jaypeeds/SCSIknifePocket/3D models/Plaque.step

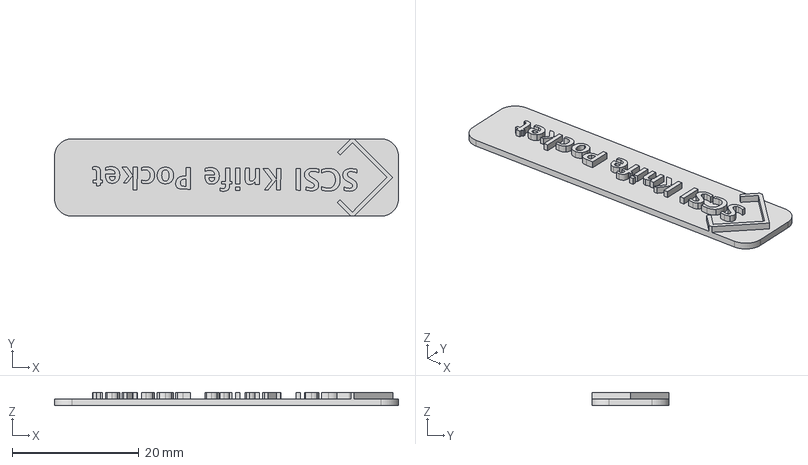
[picture p8: CAD file, 2026-02-21]
3D models/Plaque.step
54.2 x 12.2 x 2.00 mm
