jaypeeds/SCSIknifePocket/3D models/Sleeve.step

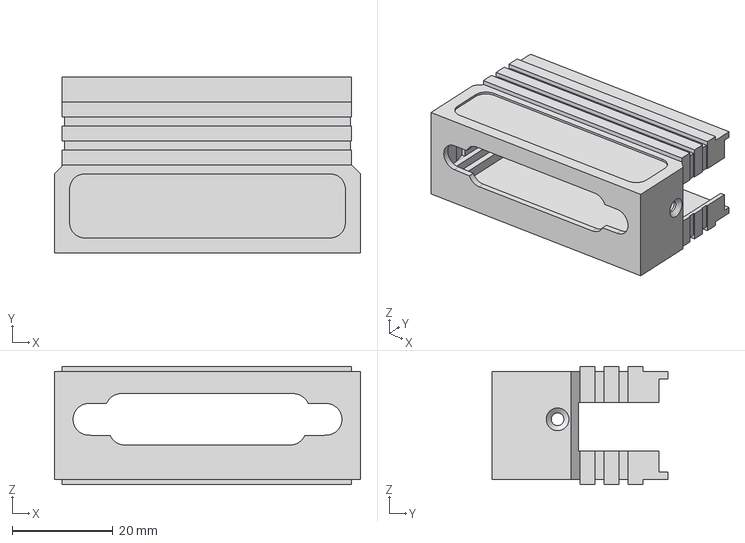
[picture p9: CAD file, 2026-02-21]
3D models/Sleeve.step
60.7 x 34.9 x 23.4 mm
