jaypeeds/SCSIknifePocket/3D models/Back.step

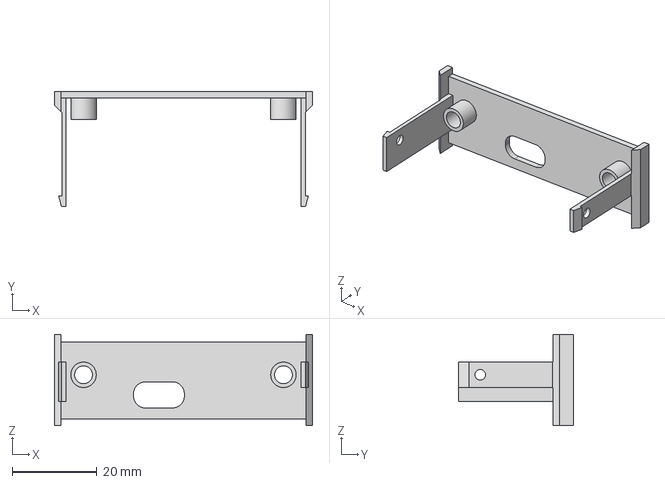
[picture p10: CAD file, 2026-02-21]
3D models/Back.step
60.7 x 27.0 x 21.4 mm
