jaypeeds/SCSIknifePocket/3D models/pcb_simplified.FCStd

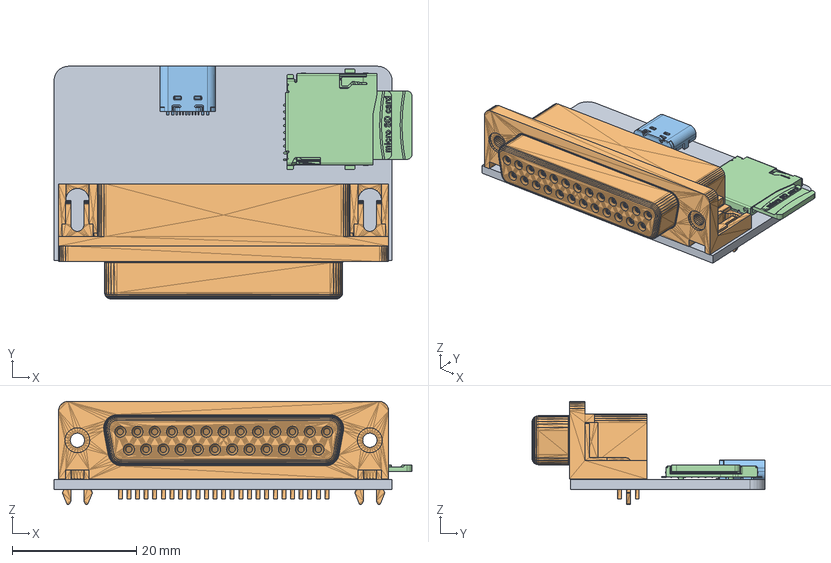
[picture p11: CAD file, 2026-02-15]
3D models/pcb_simplified.FCStd
57.6 x 37.5 x 16.6 mm
PCB001
AB2_DB25_F_RA
HRO_TYPE-C-31-M-12
L-KLS1-TF-003_ALL001
