jaypeeds/SCSIknifePocket/(list of files, cad)

Other CAD files:
3D models/Back.stl
3D models/Plaque.stl
3D models/Sleeve.stl
