jaypeeds/SCSIknifePocket/(commit log)

2026-02-15 Adding a simplified circuit 3D model
    This is a prerequisite for the design of an enclosure
    [pcb_simplified.FCStd]
2026-02-16 Adding enclosure design files
    - A STEP simplified model of the circuit
    - The projet for the enclosure design
    [SCSIPocketKnifeEnclosure.FCStd]
2026-02-19 Final version with pictures
    Current bugs in FreeCAD have not allowed to finalise the design in FreeCAD. It was done on Fusion 360. However, the .step files are loadable in FreeCAD.
    [Back Cap.step, Back Cap.stl, Sleeve.step, Sleeve.stl]
2026-02-19 Fix typo in path in README, remove unused file
    [SCSIPocketKnifeEnclosure.FCStd]
2026-02-20 Dimensions adjustment after first print
    [Back Cap.step, Back Cap.stl, Back.step, Back.stl]
2026-02-20 More rigid lid
    [Back.step, Back.stl, Sleeve.step]
2026-02-20 Missing update
    [Sleeve.stl]
2026-02-21 Cosmetic additions, plaque, hole for long screws
    [Back.step, Back.stl, Plaque.step, Plaque.stl, Sleeve.step, Sleeve.stl]
2026-02-21 Added modenature on sides
    [Sleeve.step, Sleeve.stl]
2026-02-21 Added Digikey link for long screws
2026-02-21 Added pict of PCB
2026-02-21 Add image of layout of PCB
2026-02-21 Fix text, bolder
    [Plaque.step, Plaque.stl]
2026-02-22 Added pic of printed result
